Lafayette-FSAE/GLV-Board/BOB_rev4.6.kicad_pcb

## KiCad design BOB_rev4.6.kicad_pcb (2020-02-25)

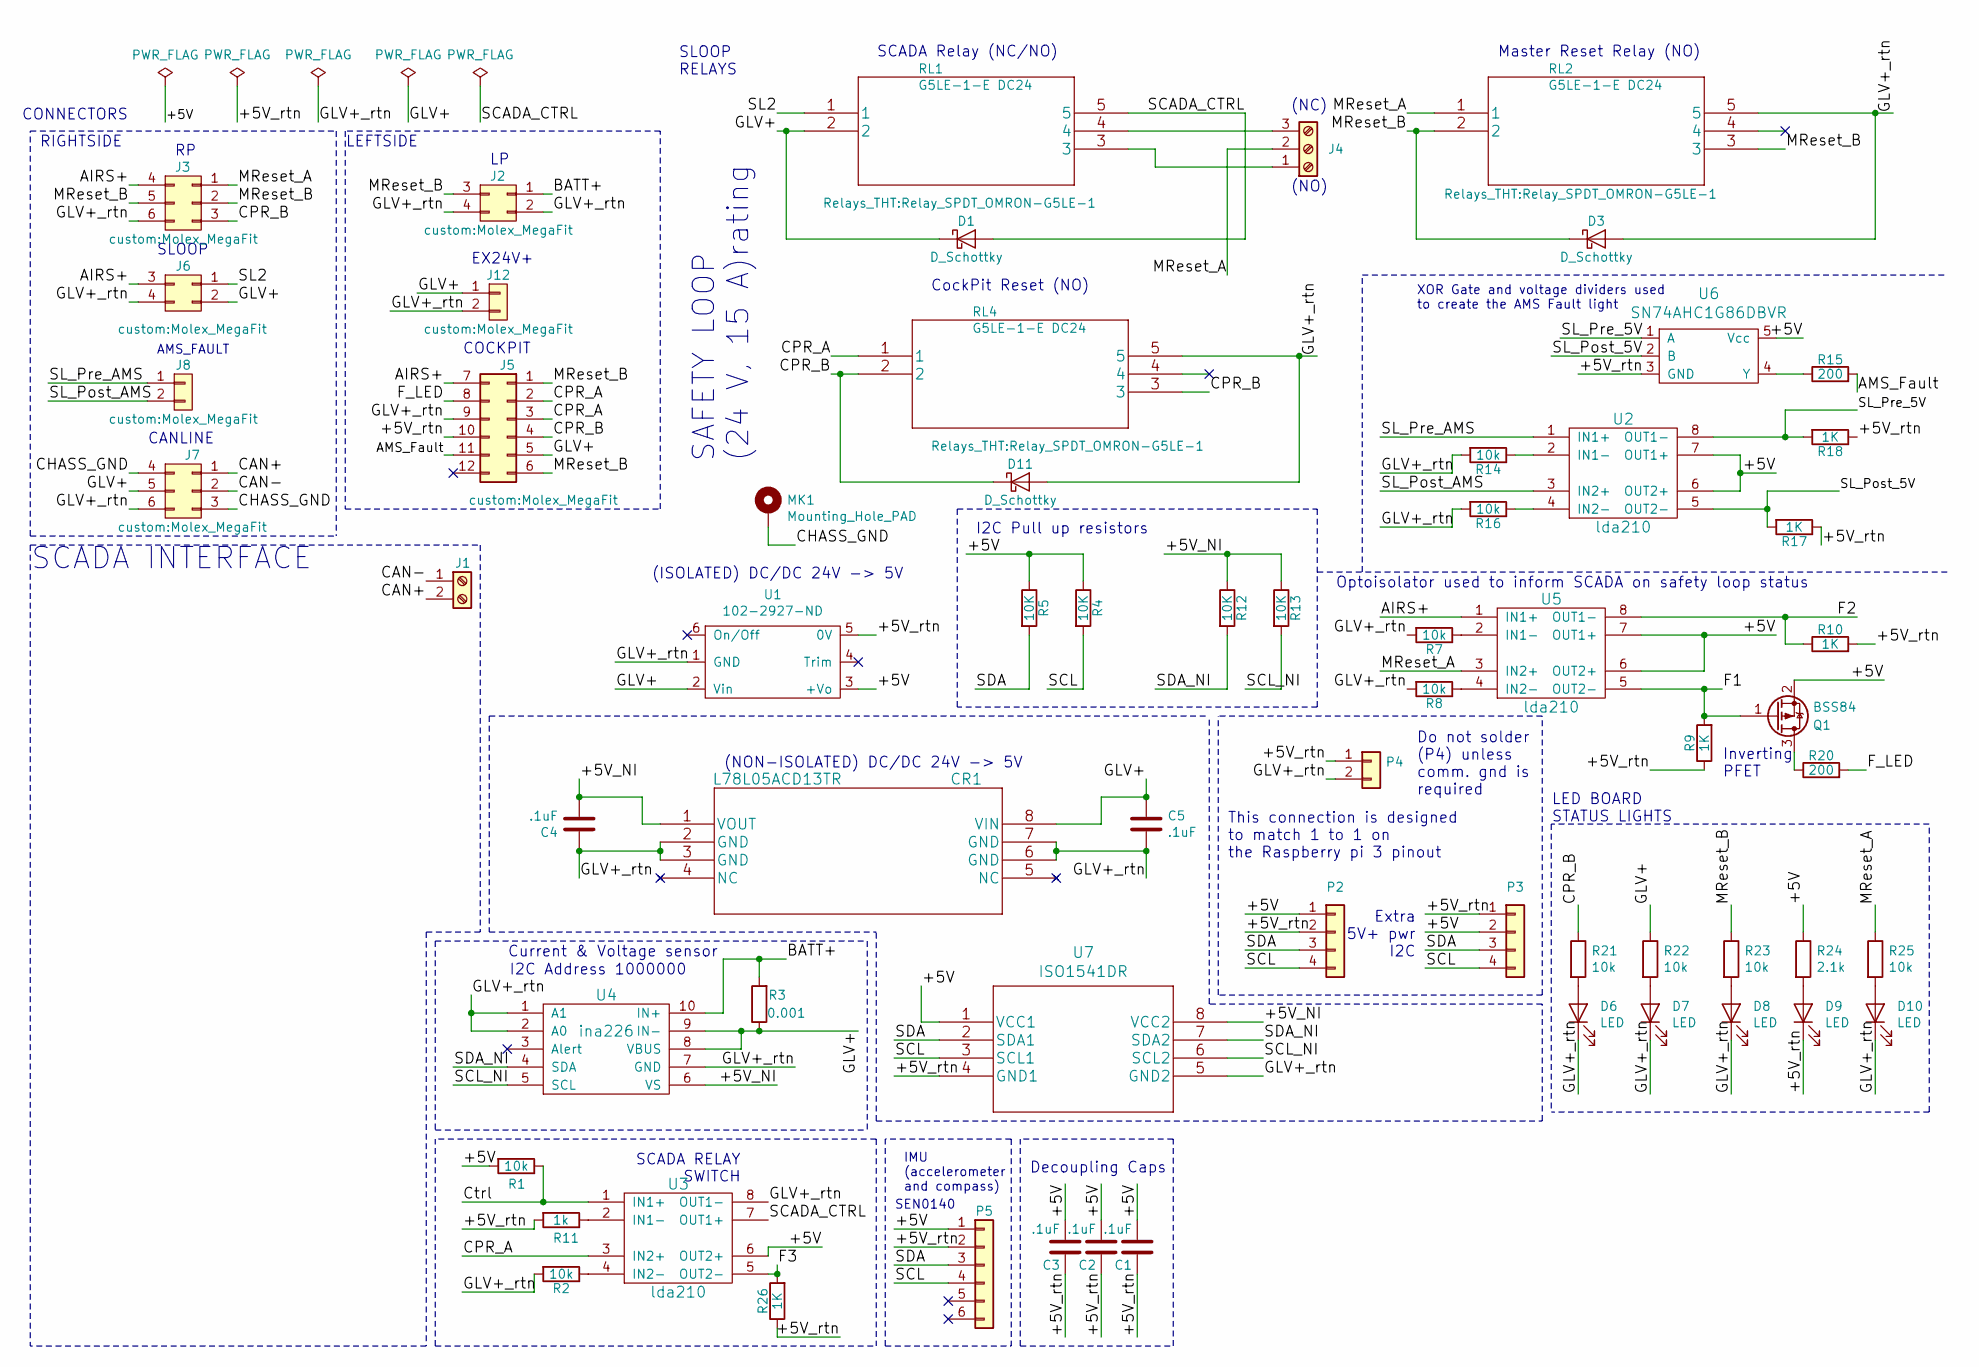
[picture p1: schematic BOB_rev4.6.sch, GLV/Safety BoB]

Parts:
C1, C2, C3, C4, C5: .1uF; C_0805_HandSoldering
CR1: L78L05ACD13TR
D1, D3, D11: D_Schottky; D_SMA_Handsoldering
D6, D7, D8, D9, D10: LED; LED_0805
J1: CONN_01X02; TerminalBlock_Pheonix_MPT-5.08mm_2pol
J2: Conn_02x02; Molex_MegaFit
J3: CONN_02X03; Molex_MegaFit
J4: CONN_01X03
J5: CONN_02X06-conn; Molex_MegaFit
J6, J7: Conn_02x03; Molex_MegaFit
J8, J12: Conn_01x02; Molex_MegaFit
MK1: Mounting_Hole_PAD; MountingHole_2.5mm_Pad
P2, P3, P5: CONN_01X04; Socket_Strip_Straight_1x04_Pitch2.54mm
P4: CONN_01X02; Socket_Strip_Straight_2x01_Pitch2.54mm
Q1: BSS84; SOT-23
R1, R2, R7, R8, R14, R16, R21, R22, R23, R25: 10k; R_0805_HandSoldering
R3: 0.001; R_0805_HandSoldering
R4, R5, R12, R13: 10K; R_0805_HandSoldering
R9, R10, R17, R18, R26: 1K; R_0805_HandSoldering
R11: 1k; R_0805_HandSoldering
R15, R20: 200; R_0805_HandSoldering
R24: 2.1k; R_0805_HandSoldering
RL1, RL2, RL4: G5LE-1-E DC24; Relay_SPDT_OMRON-G5LE-1
U1: 102-2927-ND
U2, U3, U5: lda210; DIP-8_W7.62mm
U4: ina226; msop_10_ads1015
U6: SN74AHC1G86DBVR; SOT-23-5_HandSoldering
U7: ISO1541DR

Connections:
/+5V: C1.2, C2.2, C3.2, P2.1, P3.2, P5.1, Q1.2 (S), R1.2, R4.1, R5.1, R24.1, U1.3 (+Vo), U2.6 (OUT2+), U2.7 (OUT1+), U3.6 (OUT2+), U5.6 (OUT2+), U5.7 (OUT1+), U6.5 (Vcc), U7.1 (VCC1)
/+5V_NI: C4.2, CR1.1 (VOUT), R12.1, R13.1, U4.6 (VS), U7.8 (VCC2)
/+5V_rtn: C1.1, C2.1, C3.1, D9.1 (K), J5.10, P2.2, P3.1, P4.1, P5.2, R9.1, R10.2, R11.2, R17.1, R18.1, R26.1, U1.5 (0V), U6.3 (GND), U7.4 (GND1)
/AIRS+: J3.4, J5.7, J6.3, U5.1 (IN1+)
/AMS_Fault: J5.11, R15.2
/BATT+: J2.1, R3.2, U4.10 (IN+)
/CAN+: J1.2, J7.1
/CAN-: J1.1, J7.2
/CHASS_GND: J7.3, J7.4, MK1.1
/CPR_A: J5.2, J5.3, RL4.1, U3.3 (IN2+)
/CPR_B: D11.1 (K), J3.3, J5.4, R21.1, RL4.2, RL4.3
/Ctrl: R1.1, U3.1 (IN1+)
/F1: Q1.1 (G), R9.2, U5.5 (OUT2-)
/F2: R10.1, U5.8 (OUT1-)
/F3: R26.2, U3.5 (OUT2-)
/F_LED: J5.8, R20.2
/GLV+: C5.1, CR1.8 (VIN), D1.1 (K), J5.5, J6.2, J7.5, J12.1, R3.1, R22.1, RL1.2, U1.2 (Vin), U4.8 (VBUS), U4.9 (IN-)
/GLV+_rtn: C4.1, C5.2, CR1.2 (GND), CR1.3 (GND), CR1.6 (GND), CR1.7 (GND), D3.2 (A), D6.1 (K), D7.1 (K), D8.1 (K), D10.1 (K), D11.2 (A), J2.2, J2.4, J3.6, J5.9, J6.4, J7.6, J12.2, P4.2, R2.2, R7.2, R8.2, R14.2, R16.2, RL2.5, RL4.5, U1.1 (GND), U3.8 (OUT1-), U4.1 (A1), U4.2 (A0), U4.7 (GND), U7.5 (GND2)
/MReset_A: J3.1, J4.2, R25.1, RL2.1, U5.3 (IN2+)
/MReset_B: D3.1 (K), J2.3, J3.2, J3.5, J5.1, J5.6, R23.1, RL2.2, RL2.3
/SCADA_CTRL: D1.2 (A), RL1.5, U3.7 (OUT1+)
/SCL: P2.4, P3.4, P5.4, R4.2, U7.3 (SCL1)
/SCL_NI: R13.2, U4.5 (SCL), U7.6 (SCL2)
/SDA: P2.3, P3.3, P5.3, R5.2, U7.2 (SDA1)
/SDA_NI: R12.2, U4.4 (SDA), U7.7 (SDA2)
/SL2: J6.1, RL1.1
/SL_Post_5V: R17.2, U2.5 (OUT2-), U6.2 (B)
/SL_Post_AMS: J8.2, U2.3 (IN2+)
/SL_Pre_5V: R18.2, U2.8 (OUT1-), U6.1 (A)
/SL_Pre_AMS: J8.1, U2.1 (IN1+)
unnamed: D6.2 (A), R21.2
unnamed: D7.2 (A), R22.2
unnamed: D8.2 (A), R23.2
unnamed: D9.2 (A), R24.2
unnamed: D10.2 (A), R25.2
unnamed: J4.1, RL1.3
unnamed: J4.3, RL1.4
unnamed: Q1.3 (D), R20.1
unnamed: R2.1, U3.4 (IN2-)
unnamed: R7.1, U5.2 (IN1-)
unnamed: R8.1, U5.4 (IN2-)
unnamed: R11.1, U3.2 (IN1-)
unnamed: R14.1, U2.2 (IN1-)
unnamed: R15.1, U6.4 (Y)
unnamed: R16.1, U2.4 (IN2-)

Notes on the sheet:
Optoisolator used to inform SCADA on safety loop status
I2C Pull up resistors
Master Reset Relay (NO)
SCADA Relay (NC/NO)
CockPit Reset (NO)
Decoupling Caps
SLOOP
EX24V+
Extra 5V+ pwr I2C
LED BOARD STATUS LIGHTS
SLOOP RELAYS
CONNECTORS
RIGHTSIDE
COCKPIT
SCADA INTERFACE
This connection is designed to match 1 to 1 on the Raspberry pi 3 pinout
(NC)
(NO)
SAFETY LOOP (24 V, 15 A)rating
(NON-ISOLATED) DC/DC 24V -> 5V
SCADA RELAY SWITCH
Current & Voltage sensor
I2C Address 1000000
IMU (accelerometer and compass)
XOR Gate and voltage dividers used to create the AMS Fault light
(ISOLATED) DC/DC 24V -> 5V
SEN0140
AMS_FAULT
Do not solder (P4) unless comm. gnd is required
Inverting PFET
CANLINE
LEFTSIDE

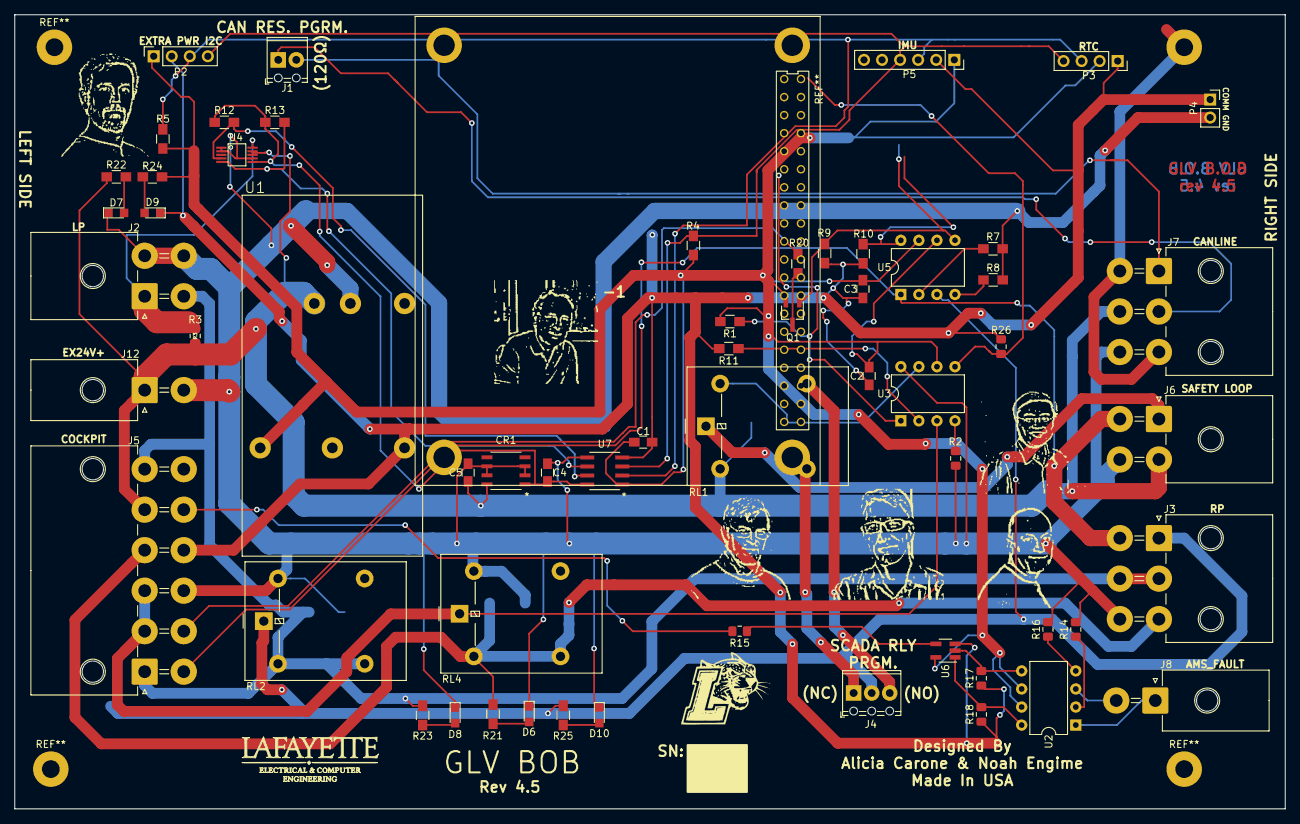
[picture p2: board BOB_rev4.6.kicad_pcb from above]

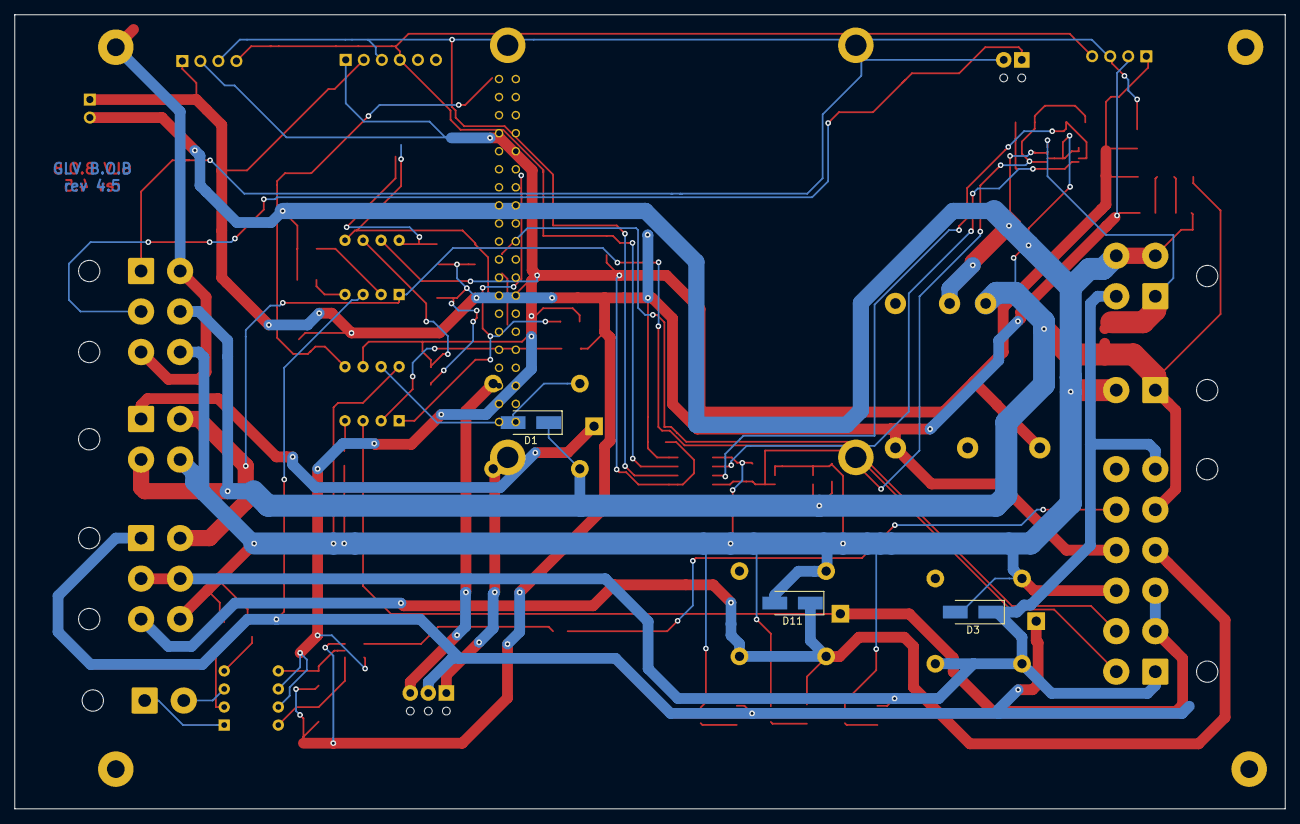
[picture p3: board BOB_rev4.6.kicad_pcb from below]

Board: 2 copper layers, 178.8 x 111.8 mm, 69 parts (3 on the bottom side), 45 nets.

Other parts of the board:
LOGO: LOGO
nadovich: nadovich
nestor: nestor
wallace: wallace
wey: wey
yu: yu
